omonge22/evoz3D/README.md

# evoz3D :alien: 

## Contenidos
  1. [Introducción](#Introducción)
  1. [Firmware ](#Firmware)
  1. [ANTENCION!!:warning:](#atencion-warning)
  1. [Perfiles de Laminado PrusaSlicer / SuperSlicer](#Perfiles-de-Laminado-PrusaSlicer--SuperSlicer)
  1. [Custom Buildplate](#Custom-Buildplate)
  1. [Apoya mi Trabajo](#Apoya-mi-Trabajo)
  1. [Gracias](#Gracias)

## Introducción
**evoz3D** :alien: es una empresa costarricense especializada en diseño e ingeniería que desarrolla y estimula la creatividad en productos y servicios 3D

El siguiente repositorio contiene las configuraciones para las impresoras utilizadas/desarrolladas/ajustadas por **evoz3D** :alien: en términos de Firmware y relacionado, así como las [configuraciones de laminado](https://github.com/omonge22/evoz3D#perfiles-de-laminado-prusaslicer--superslicer) para el software PrusaSlicer y SuperSlicer para dichas impresoras...

Adicional se encuentran los [**_Custom Buildplate_**](#Custom-Buildplate) para cada uno de los equipos.

En el apartado [wiki](https://github.com/omonge22/evoz3D/wiki) se encuentra el detalle de cada equipo...

<br/>

## ATENCION!!! :warning:
### La información contenida en el este repositorio es libre de usarse por cualquier persona, sin embargo, **ÚSESE BAJO SU PROPIO RIESGO** <br><br>**evoz3D**:alien: y el creador de este contenido no se responsabilizaran de cualquier impresora 3D dañada.

***
***

## Firmware 
[](https://github.com/makerbase-mks) [](https://github.com/bigtreetech) [](https://github.com/omonge22/Marlin) 

 ### Impresoras

* #### aRtiLLeRY GENIUS [wiki](https://github.com/omonge22/evoz3D/wiki/aRtiLLeRY-GENIUS)
  * **Marlin 2.0.7.2**
    *  [BTT TFT35 V3.0 evoz3D👽 Firmware Vx.x.27](https://github.com/omonge22/BIGTREETECH-TouchScreenFirmware/tree/BTT-TFT35V3.0/_aRtiLLeRY%20GENIUS%20TFT35V3.0) | [evoz3D:alien: Marlin Firmware 2.0.7.2](https://github.com/omonge22/Marlin/tree/_aRtiLLeRY-GENIUS_evoz3D-Marlin)
    * SKR1.4Turbo [_in process_](https://raw.githubusercontent.com/omonge22/evoz3D/main/resources/icons/web-pc.jpg)

  *  **Factory**
  * > Recursos tomados del repositorio de [aRtiLLeRY 3D](https://github.com/artillery3d) 
    * [Marlin 1.1.9](https://github.com/omonge22/genius-firmware)
    * [TFT: mkstft28](https://github.com/omonge22/genius-tft-firmware)
    * [Contenido USB](https://drive.google.com/file/d/1ymOYUReszwrEQ4nJWugZOiGnmjrinvXf/view)
    * [Cura Profile](https://github.com/artillery3d/slicer_profiles)
    * [PDF Manual](https://drive.google.com/file/d/103mb-JaXS-LajUZ2fF9sH9GxXkMXWKK5/view)
  * **evoz3D** :alien: Repositorio [Factory Marlin 1.1.9](https://github.com/omonge22/Marlin/tree/_aRtiLLeRY-GENIUS_evoz3D-Factory-Marlin) 
  
  ***

* #### Prusa BEAR Custom [wiki](https://github.com/omonge22/evoz3D/wiki/Prusa-BEAR-Custom) 
  * BMG Extruder [evoz3D:alien: Marlin Firmware 2.0.7.2](https://github.com/omonge22/Marlin/tree/_Prusa-BEAR-evoz3D-Marlin-Firmware)
  * BEAR Extruder [_in process_](https://raw.githubusercontent.com/omonge22/evoz3D/main/resources/icons/web-pc.jpg)

  ***

* #### Prusa MINI FRANKENSTEIN [wiki](https://github.com/omonge22/evoz3D/wiki/Prusa-FRANKENSTEIN-MINI)
  * [evoz3D👽 Marlin Firmware 2.0.7.2](https://github.com/omonge22/Marlin/tree/_Prusa-FRANKENSTEIN-MINI-evoz3D-Marlin-Firmware)
  * [_in process_ Marlin 2.0.8.x](https://raw.githubusercontent.com/omonge22/evoz3D/main/resources/icons/web-pc.jpg)

  ***

* #### BLV-EVA [wiki](https://github.com/omonge22/evoz3D/wiki/BLV-EVA)
  * [evoz3D👽 Marlin Firmware 2.0.8.2](https://github.com/omonge22/Marlin/tree/_BLV-EVA)

  ***

* #### PORTU Prusa BEAR [wiki](https://github.com/omonge22/evoz3D/wiki/PORTU-Prusa)
  * [evoz3D👽 Marlin Firmware 2.0.9](https://github.com/omonge22/Marlin/tree/_PORTU-Prusa-BEAR-evoz3D-Marlin-Firmware)

  ***

* #### Kingroom Kp3S [wiki ](https://github.com/omonge22/evoz3D/wiki/Kingroon-KP3S)
  * **Titan Extruder Clone / Ajuste de Microstep**
    * [Procedimiento](https://github.com/omonge22/evoz3D/wiki/Kingroon-KP3S#actualizatci%C3%B3n-titan-extruder-clone-)

  * **Factory**
   * > Recursos tomados de [Kingroon.com](https://www.kingroon.com/downloads/)
     * Marlin (.bin)
       * [Firmware Marlin 1.0.0](https://github.com/omonge22/evoz3D/tree/main/resources/Kingroon%20Factory/KP3S-Firmware-201022)
       * [Firmware - BLTouch](https://github.com/omonge22/evoz3D/tree/main/resources/Kingroon%20Factory/KP3S-Firmware-3Dtouch)
     * [Contenido USB](https://drive.google.com/file/d/1L9fIGaFAllFT-b9qKtVpjevujm8QpJ2f/view)
     * [PDF Manual](https://github.com/omonge22/evoz3D/blob/main/resources/Kingroon%20Factory/KP3S-Manual.pdf) 

***
***

## Perfiles de Laminado PrusaSlicer / SuperSlicer
### Impresoras agregadas:
#### [Prusa Slicer](https://github.com/omonge22/evoz3D/tree/main/PrusaSlicer_config_bundle) 

* aRtiLLeRY GENIUS
* Prusa BEAR Custom
* Prusa FRANKESTEIN MINI (_Proyecto abandonado_)
* BLV-EVA [_in process..._](https://raw.githubusercontent.com/omonge22/evoz3D/main/resources/icons/web-pc.jpg)
* PORTU Prusa [_in process..._](https://raw.githubusercontent.com/omonge22/evoz3D/main/resources/icons/web-pc.jpg)

#### [Super Slicer](https://github.com/omonge22/evoz3D/tree/main/SuperSlicer_config_bundle) 
* aRtiLLeRY GENIUS
* Prusa BEAR Custom
* BLV-EVA [_in process..._](https://raw.githubusercontent.com/omonge22/evoz3D/main/resources/icons/web-pc.jpg)
* PORTU Prusa [_in process..._](https://raw.githubusercontent.com/omonge22/evoz3D/main/resources/icons/web-pc.jpg)

***
***

## Custom Buildplate
Las carpetas _Custom Buildplate_ permiten personalizar el entorno del laminador para mostrar una imagen similar a la cama física de la impresora.

Se adjuntan 3 archivos:
* **.stl** el cual muestra el modelado 3D de la superficie de impresión.
* **.png** el cual muestra los logos dibujados en la superficie de impresión.
* **.xcf** el cual es la extesión del programa **[_gimp_](http://www.gimp.org.es/)** para personalizar los logos/superfices. 

### Impresoras
* [aRtiLLeRY GENIUS](https://github.com/omonge22/evoz3D-Config_Bundle/tree/main/Custom%20Buildplate/aRtiLLeRY%20GENIUS)
* [Prusa MINI FRANKENSTEIN](https://github.com/omonge22/evoz3D-Config_Bundle/tree/main/Custom%20Buildplate/Prusa%20MINI%20FRANKENSTEIN)
* BLV-EVA [_in process..._](https://raw.githubusercontent.com/omonge22/evoz3D/main/resources/icons/web-pc.jpg)

***
***

## Apoya mi Trabajo
paypal.me (https://www.paypal.me/omonge22)<br/>[paypal.me/omonge22](https://www.paypal.me/omonge22)
<br/><br/>
También podrías invitarme a un café en [Thingiverse](https://www.thingiverse.com/omonge22/designs) si asi lo prefieres.

## Gracias
A todas aquellas personas que permiten que **evoz3D** :alien: sea parte de sus proyectos...
