omonge22/evoz3D/SuperSlicer_config_bundle/README.md

# SuperSlicer_config_bundle

## SuperSlicer Version: 2.3.56

### Perfiles de impresion
Impresora|Perfil de Impresion
  -------|---------
  MASTER|ALL
  aRtiLLeRY GENIUS|Master Default <br/> TEST - 0.2mm CALIDAD
  Prusa BEAR|Master Default <br/> TEST - 0.2mm CALIDAD
