omonge22/evoz3D/PrusaSlicer_config_bundle/README.md

# PrusaSlicer_config_bundle

## Prusa Slicer Version: 2.3.0

### Perfiles de impresion
Impresora|Perfil de Impresion
  -------|---------
  MASTER|ALL
  aRtiLLeRY GENIUS|Master Default <br/> 0.2mm CALIDAD <br/> PETG#05 - 0.2mm CALIDAD<br/> PETG#09 - 0.2mm CALIDAD <br/> PETG#10 - 0.2mm CALIDAD <br/> PLA_MAX#08 - 0.2mm CALIDAD
  Prusa FRAKENSTEIN MINI|Master Default <br/> 0.2mm CALIDAD
