omonge22/evoz3D/resources/Kingroon Factory/README.md

# KINGROON 

Este directorio contiene los Firmware publicados por Kingroon en su página principal para la impresora **Kingroon KP3S**

***

El fichero _**Kingroon-KP3S-Marlin-stock**_ contiene la configuracion para Marlin 2.0.7.2
> **NO PROBADO**
