omonge22/evoz3D/resources/Kingroon Factory/KP3S-Firmware-3Dtouch/PCB.jpg

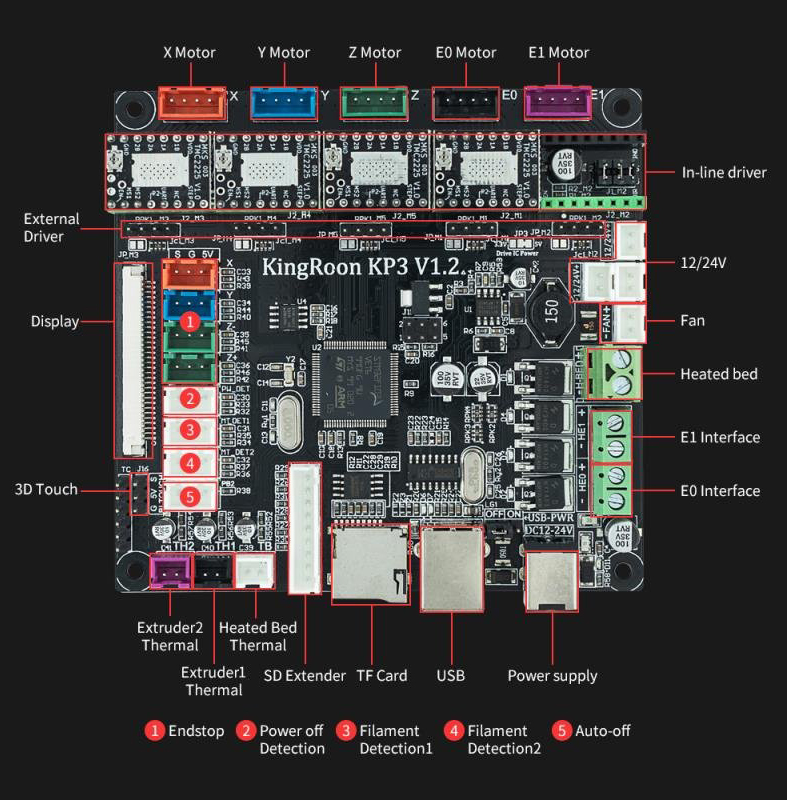
resources/Kingroon Factory/KP3S-Firmware-3Dtouch/PCB.jpg
