omonge22/evoz3D/Custom Buildplate/aRtiLLeRY GENIUS/Artillery Genius Bed.stl

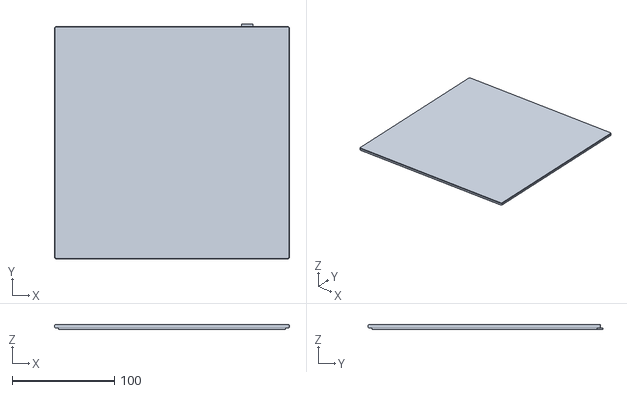
[picture p2: CAD file, 2021-06-08]
Custom Buildplate/aRtiLLeRY GENIUS/Artillery Genius Bed.stl
230.0 x 230.0 x 5.00
