omonge22/evoz3D/Custom Buildplate/Prusa MINI FRANKENSTEIN/FRANKENSTEIN Bed.stl

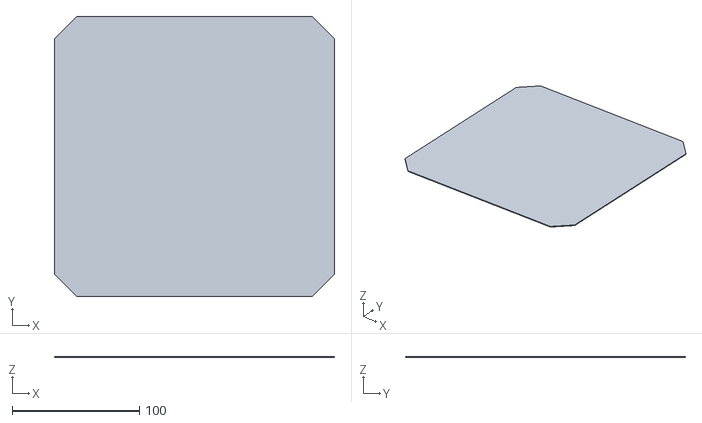
[picture p3: CAD file, 2021-06-08]
Custom Buildplate/Prusa MINI FRANKENSTEIN/FRANKENSTEIN Bed.stl
220.0 x 220.0 x 0.8
