omonge22/evoz3D/(list of files, cad)

Other CAD files:
resources/Kingroon Factory/KP3S-Firmware-3Dtouch/KP3S-3Dtouch-Holder.STL
