omonge22/evoz3D/resources/Drawing/Titan Extruder/Titan Assembly.pdf

# ASSEMBLY OVERVIVEW

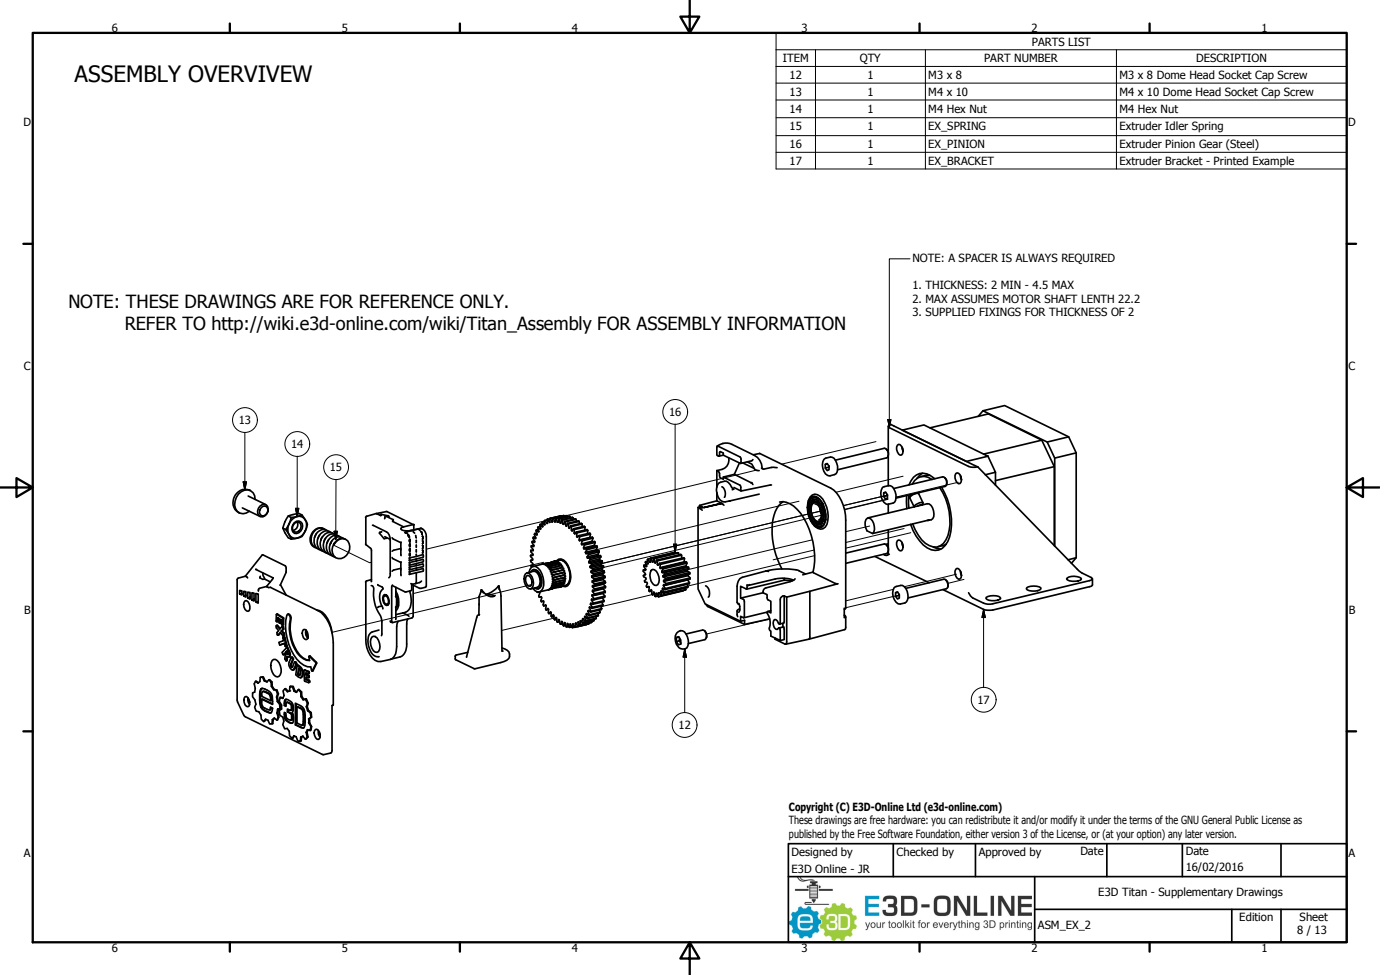
[picture p13: page 1]
PARTS LIST; ITEM; QTY; PART NUMBER; DESCRIPTION; M3 x 8 Dome Head Socket Cap Screw; M4 x 10 Dome Head Socket Cap Screw; M4 Hex Nut; EX_SPRING; Extruder Idler Spring; EX_PINION; Extruder Pinion Gear (Steel); EX_BRACKET; Extruder Bracket - Printed Example; ASM_EX_2; E3D Online - JR; Designed by; Checked by; Approved by; Date; Edition; Sheet

NOTE: A SPACER IS ALWAYS REQUIRED

1. THICKNESS: 2 MIN - 4.5 MAX
2. MAX ASSUMES MOTOR SHAFT LENTH 22.2
3. SUPPLIED FIXINGS FOR THICKNESS OF 2

NOTE: THESE DRAWINGS ARE FOR REFERENCE ONLY.

REFER TO http://wiki.e3d-online.com/wiki/Titan_Assembly FOR ASSEMBLY INFORMATION

Copyright (C) E3D-Online Ltd (e3d-online.com)
These drawings are free hardware: you can redistribute it and/or modify it under the terms of the GNU General Public License as
published by the Free Software Foundation, either version 3 of the License, or (at your option) any later version.

E3D Titan - Supplementary Drawings

# ASSEMBLY STEPS 1-4

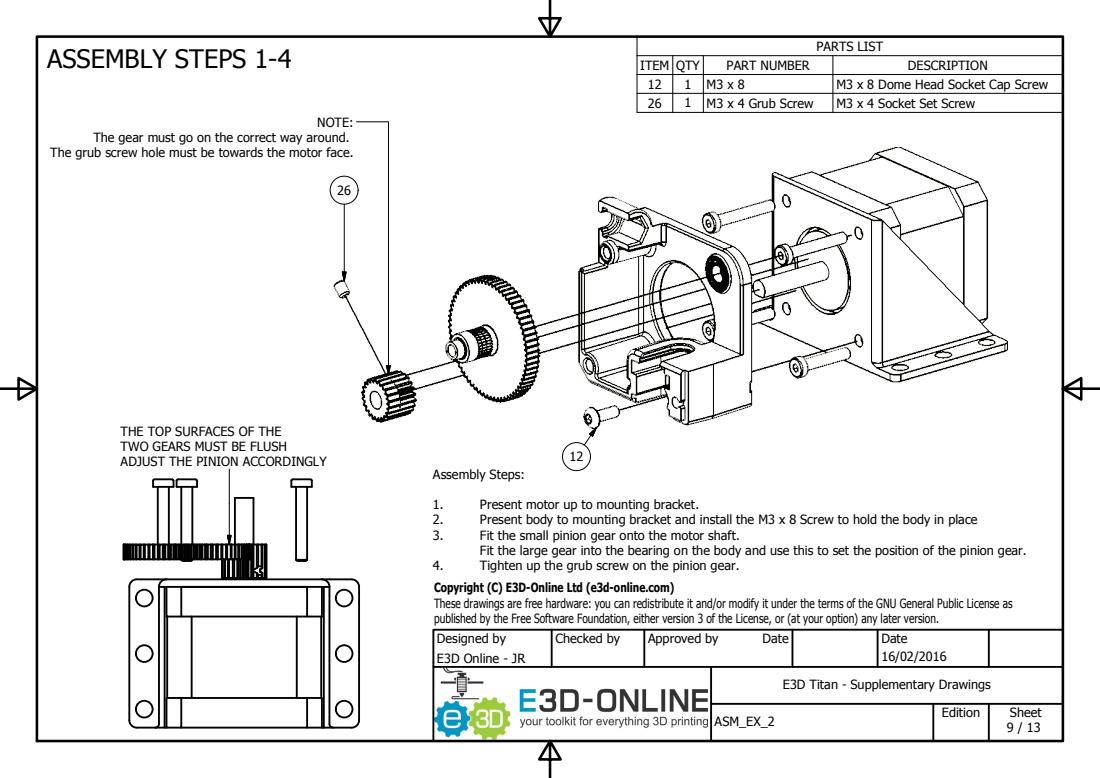
[picture p14: page 2]
ITEM; QTY; PART NUMBER; DESCRIPTION; M3 x 8 Dome Head Socket Cap Screw; M3 x 4 Grub Screw; M3 x 4 Socket Set Screw; E3D Online - JR; Designed by; Checked by; Approved by; Date; Edition; Sheet; Assembly Steps:; NOTE:

The gear must go on the correct way around.

The grub screw hole must be towards the motor face.

THE TOP SURFACES OF THE
TWO GEARS MUST BE FLUSH
ADJUST THE PINION ACCORDINGLY

1. Present motor up to mounting bracket.
2. Present body to mounting bracket and install the M3 x 8 Screw to hold the body in place
3. Fit the small pinion gear onto the motor shaft.

Fit the large gear into the bearing on the body and use this to set the position of the pinion gear.

4. Tighten up the grub screw on the pinion gear.
Copyright (C) E3D-Online Ltd (e3d-online.com)
These drawings are free hardware: you can redistribute it and/or modify it under the terms of the GNU General Public License as
published by the Free Software Foundation, either version 3 of the License, or (at your option) any later version.

E3D Titan - Supplementary Drawings

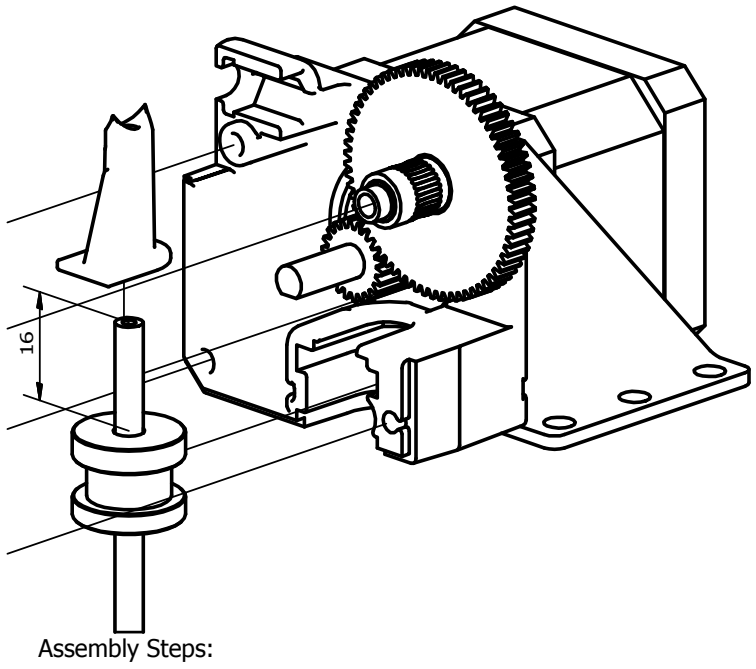
[picture p15: figure]
Assembly Steps:

ITEM | QTY | PART NUMBER | DESCRIPTION
14 | 1 | M4 Hex Nut | M4 Hex Nut
13 | 1 | M4 x 10 | M4 x 10 Dome Head Socket Cap Screw
27 | 1 | PTFE

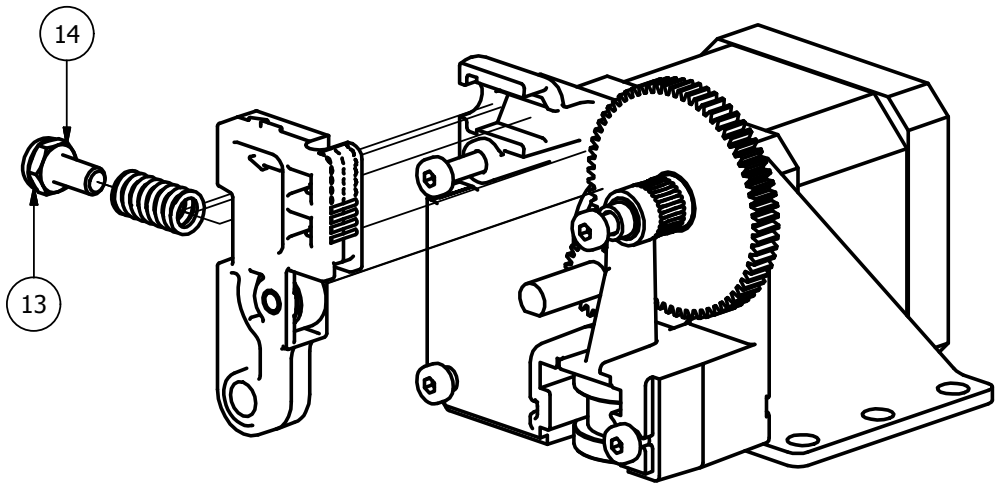
[picture p16: figure]
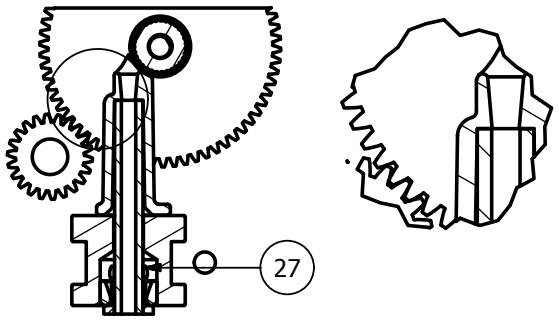
[picture p17: figure]

E3D Titan - Supplementary Drawings

E3D Online - JR | 16/02/2016
Designed by | Checked by | Approved by | Date
Edition | Sheet

Date

Copyright (C) E3D-Online Ltd (e3d-online.com)
These drawings are free hardware: you can redistribute it and/or modify it under the terms of the GNU General Public License as published by the Free Software Foundation, either version 3 of the License, or (at your option) any later version.
5. Install the filament guide and HotEnd into the extruder body. For the 1.75mm version, make sure the PTFE goes all the way up into the filament guide. See cutout below.
Rotate the HotEnd if necessary to insert.

Note: The diagram shows a bowden adaptor for a bowden setup,
if you are using a direct, there will be a HotEnd in place of this part.

Assembly Steps:

6. Slide the lever onto the motor shaft.
7. Screw the M4 Nut fully onto the M4 x 10 Screw
8. Slide the spring onto the screw and insert the assembly into the slot as shown.

Note: This bit is fiddly. Don't add any tension to the spring,
it will fly across the room to be lost forever.

# ASSEMBLY STEPS 5-8

# ASSEMBLY STEP 9

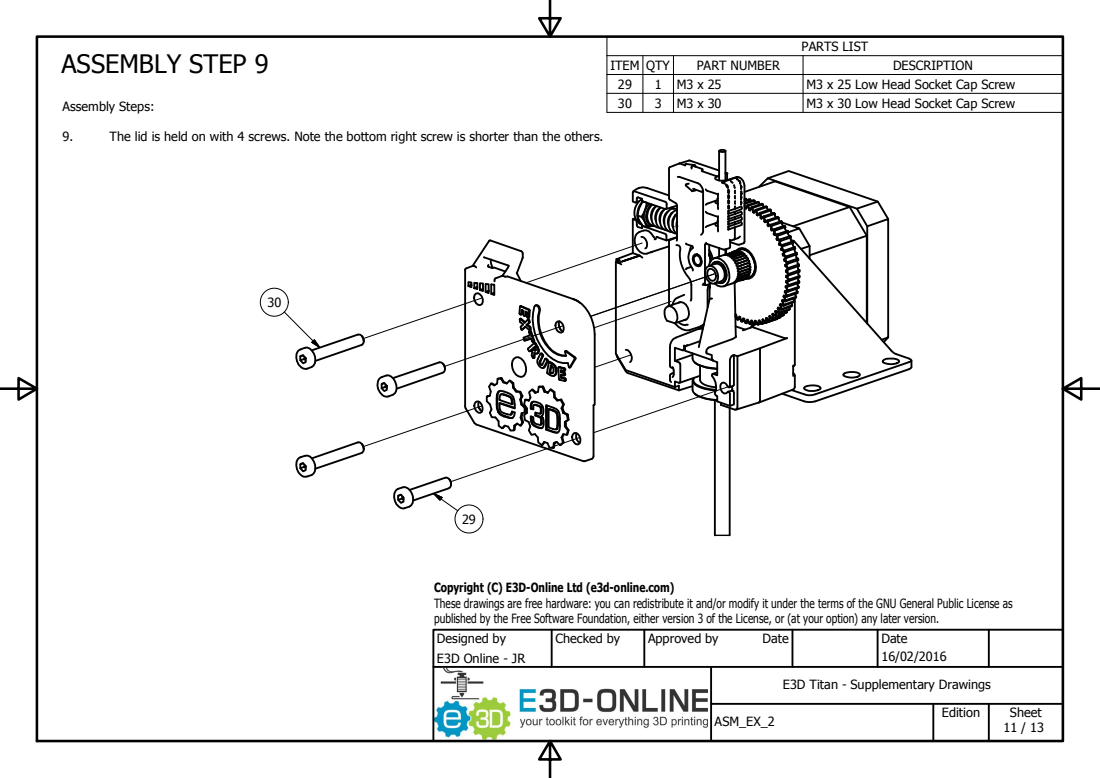
[picture p18: page 4]
ITEM; QTY; PART NUMBER; DESCRIPTION; M3 x 25 Low Head Socket Cap Screw; M3 x 30 Low Head Socket Cap Screw; E3D Online - JR; Designed by; Checked by; Approved by; Date; Edition; Sheet; Assembly Steps:

9. The lid is held on with 4 screws. Note the bottom right screw is shorter than the others.

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

E3D Titan - Supplementary Drawings

# TITAN EXTRENAL DIM'S

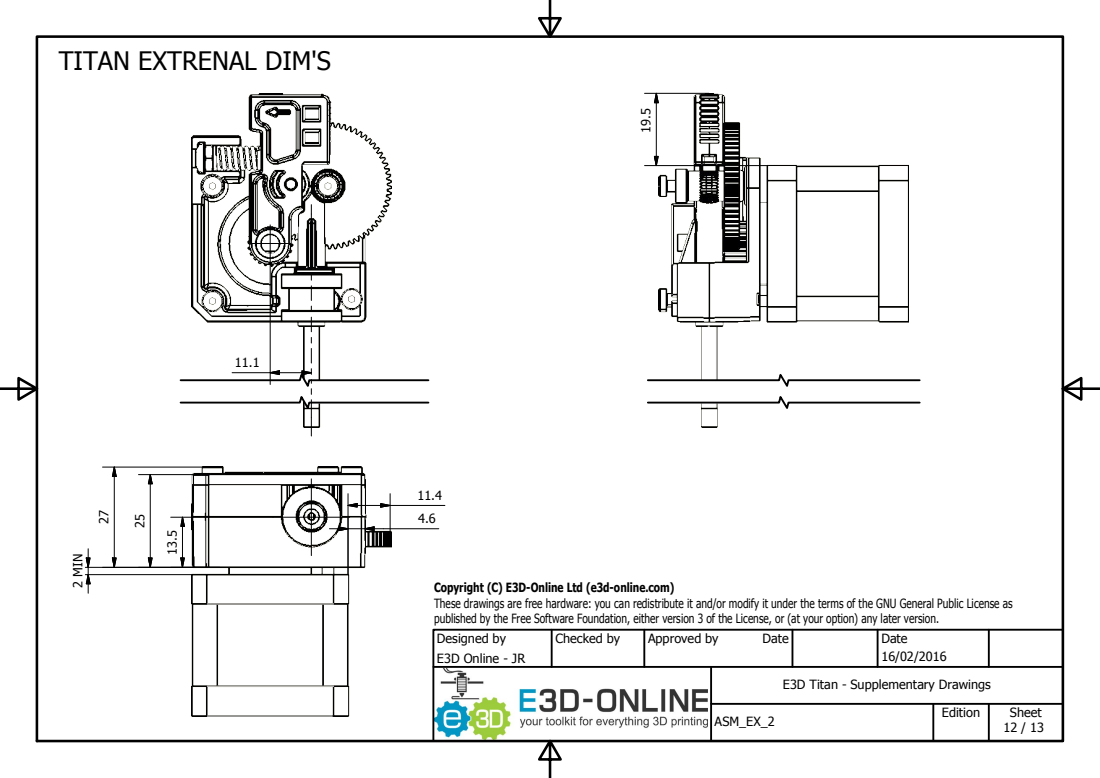
[picture p19: page 5]
E3D Online - JR; Designed by; Checked by; Approved by; Date; Edition; Sheet; 2 MIN

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

E3D Titan - Supplementary Drawings
