omonge22/evoz3D/resources/Datasheet/TMC2225/TMC2225 Microstep setup.png

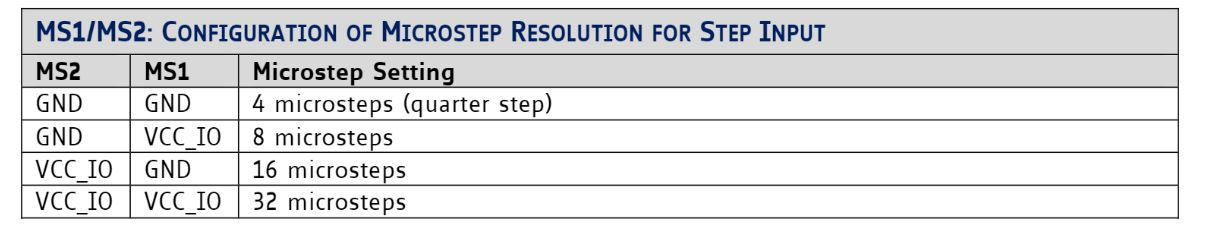
resources/Datasheet/TMC2225/TMC2225 Microstep setup.png
