omonge22/evoz3D/resources/Drawing/V6 Nozzle/V6 Assembly.pdf

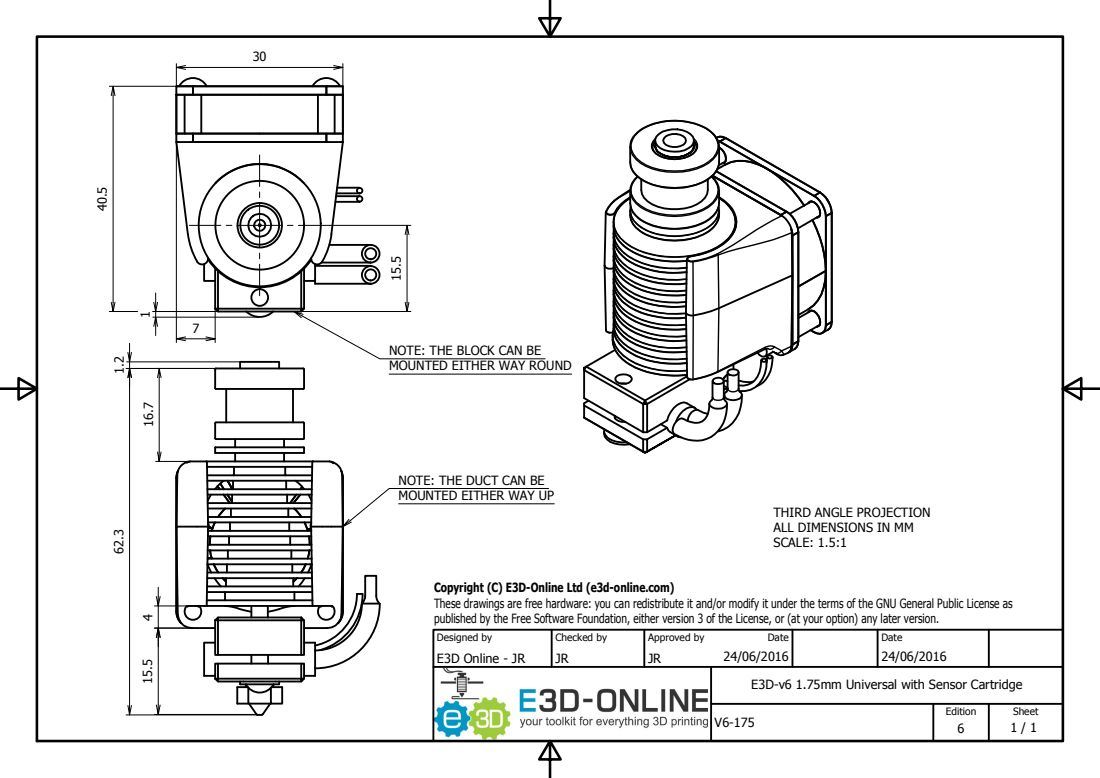
[picture p21: page 1]
E3D Online - JR; Designed by; Checked by; Approved by; Date; Edition; Sheet

NOTE: THE BLOCK CAN BE
MOUNTED EITHER WAY ROUND

NOTE: THE DUCT CAN BE
MOUNTED EITHER WAY UP

THIRD ANGLE PROJECTION
ALL DIMENSIONS IN MM
SCALE: 1.5:1

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

E3D-v6 1.75mm Universal with Sensor Cartridge
