omonge22/evoz3D/resources/Drawing/Volcano Nozzle/Volcano Nozzle Assembly.pdf

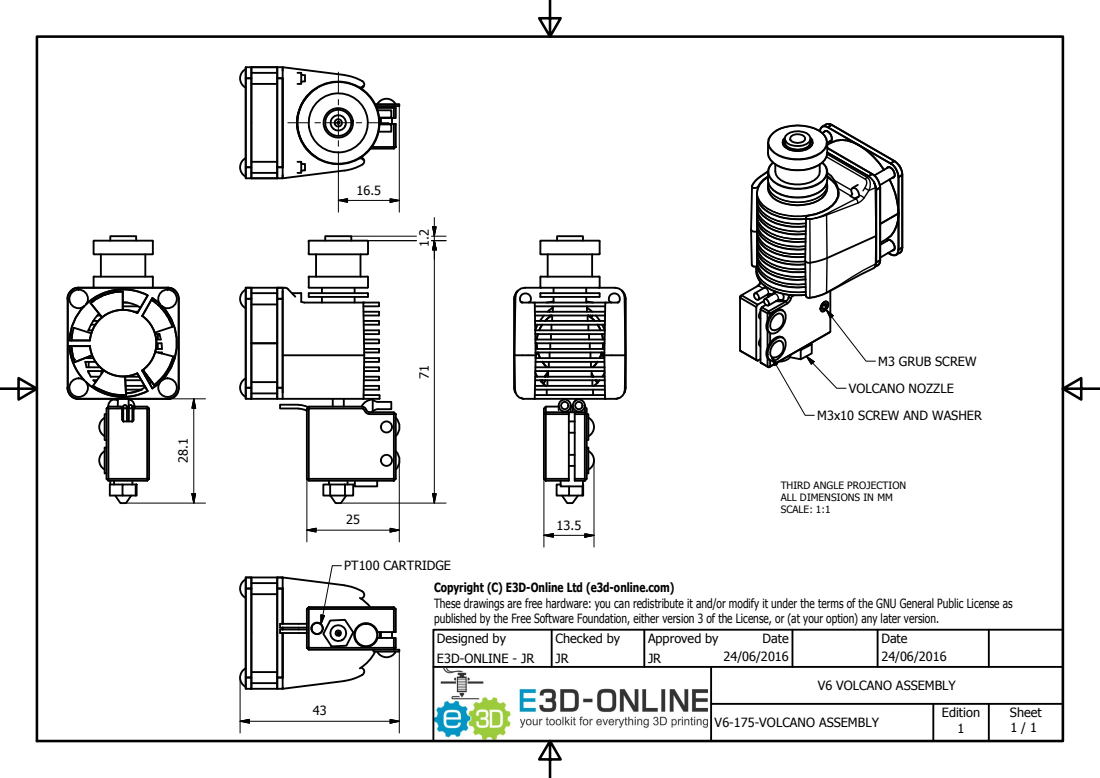
[picture p22: page 1]
V6 VOLCANO ASSEMBLY; V6-175-VOLCANO ASSEMBLY; E3D-ONLINE - JR; Designed by; Checked by; Approved by; Date; Edition; Sheet; M3 GRUB SCREW; VOLCANO NOZZLE; PT100 CARTRIDGE

M3x10 SCREW AND WASHER

THIRD ANGLE PROJECTION
ALL DIMENSIONS IN MM
SCALE: 1:1

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
