omonge22/evoz3D/resources/Drawing/Volcano Nozzle/Volcano Block.pdf

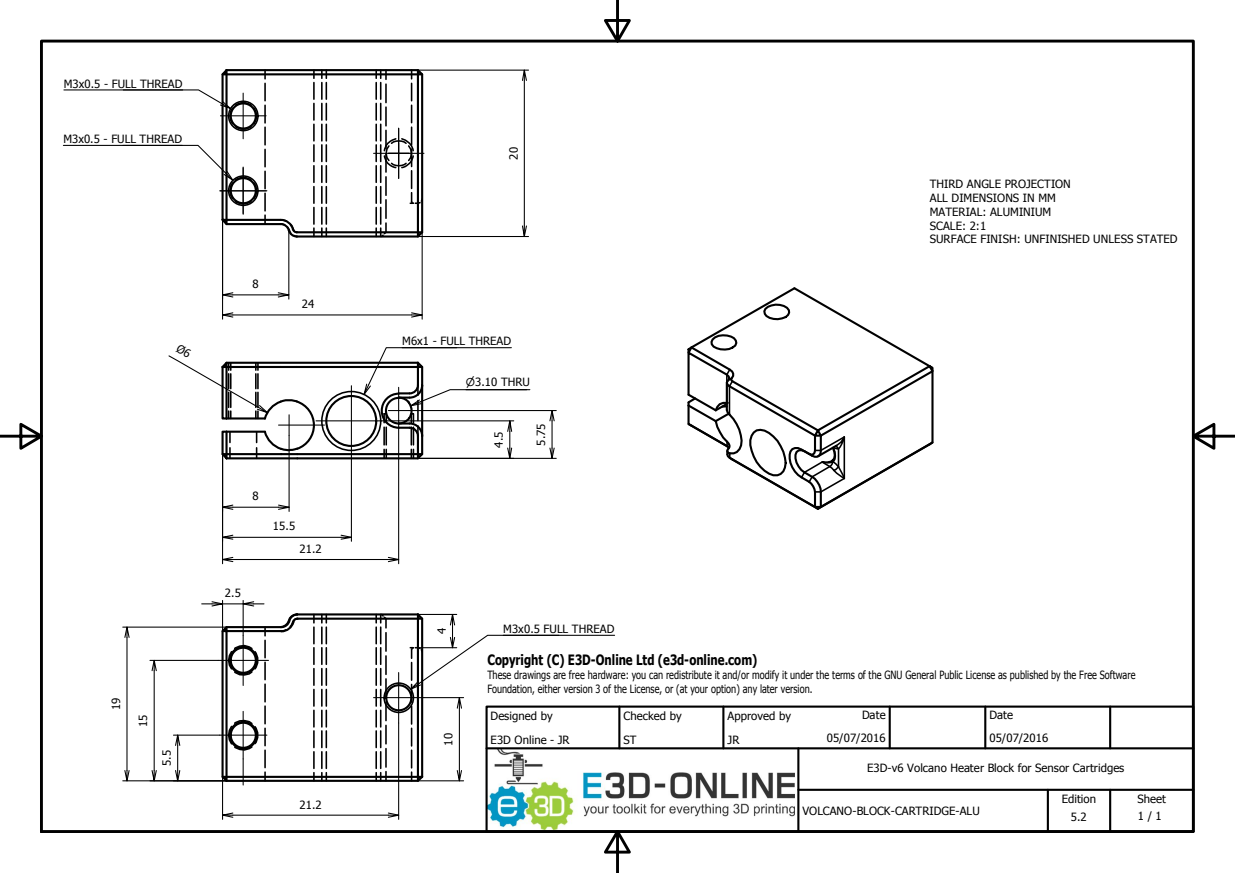
[picture p23: page 1]
E3D Online - JR; Designed by; Checked by; Approved by; Date; Edition; Sheet; M3x0.5 - FULL THREAD; M6x1 - FULL THREAD; P3.10 THRU; M3x0.5 FULL THREAD

THIRD ANGLE PROJECTION
ALL DIMENSIONS IN MM
MATERIAL: ALUMINIUM
SCALE: 2:1
SURFACE FINISH: UNFINISHED UNLESS STATED

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

E3D-v6 Volcano Heater Block for Sensor Cartridges

VOLCANO-BLOCK-CARTRIDGE-ALU
