omonge22/evoz3D/resources/Drawing/Volcano Nozzle/Volcano Nozzle.pdf

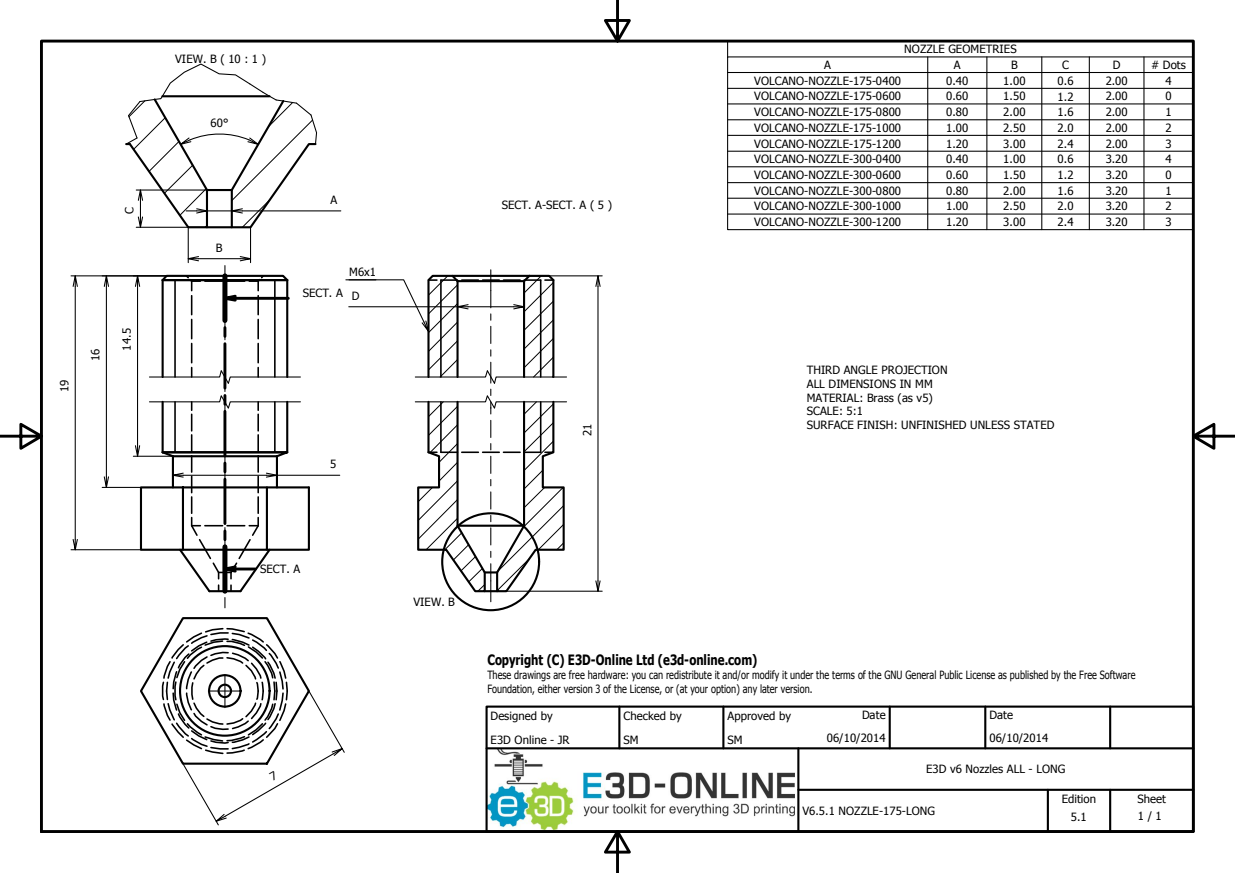
[picture p24: page 1]
SECT. A-SECT. A ( 5 ); VIEW. B ( 10 : 1 ); SECT. A; VIEW. B; V6.5.1 NOZZLE-175-LONG; E3D Online - JR; Designed by; Checked by; Approved by; Date; Edition; Sheet; NOZZLE GEOMETRIES; # Dots; VOLCANO-NOZZLE-175-0400; VOLCANO-NOZZLE-175-0600; VOLCANO-NOZZLE-175-0800; VOLCANO-NOZZLE-175-1000; VOLCANO-NOZZLE-175-1200; VOLCANO-NOZZLE-300-0400; VOLCANO-NOZZLE-300-0600; VOLCANO-NOZZLE-300-0800; VOLCANO-NOZZLE-300-1000; VOLCANO-NOZZLE-300-1200

THIRD ANGLE PROJECTION
ALL DIMENSIONS IN MM
MATERIAL: Brass (as v5)
SCALE: 5:1
SURFACE FINISH: UNFINISHED UNLESS STATED

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

E3D v6 Nozzles ALL - LONG
