omonge22/evoz3D/(commit log)

2021-06-09 add KP3S-Firmware-3Dtouch
    [KP3S-3Dtouch-Holder.STEP, KP3S-3Dtouch-Holder.STL, KP3S-3Dtouch-Holder2.STEP]
2021-06-09 add Extruder Titan
2021-06-09 add Datasheet
    [TMC5130_TMC2130_TMC2100_Calculations.xlsx]
2021-06-09 add V6 Nozzle
2021-06-10 Wiki movido a la pagina del repositorio wiki
    Se elimina el apartado Wiki ya que se agrega ala Wiki propia del repositorio
2021-06-10 Kingroon Conf Marlin 2.0.7.2
    [Configuration.h, Configuration_adv.h]
2021-06-10 add Kingroon KP3S Marlin 2.0.7.2 Conf
    [Configuration.h, Configuration_adv.h]
2021-06-10 +add kingroom titan extruder.png
2021-06-11 add Current
