omonge22/evoz3D/(notices)

Notices in the files:
resources/Kingroon Factory/Kingroon-KP3S-Marlin-stock/Configuration.h:
Copyright (c) 2020 MarlinFirmware [https://github.com/MarlinFirmware/Marlin]
Copyright (c) 2011 Camiel Gubbels / Erik van der Zalm
This program is free software: you can redistribute it and/or modify
